kalivoid2047/TIFF_TESTER_PRO_SD/ESP32_Firmware_V2/README.md

# ESP32_Firmware_V2 — Bluetooth Classic "V2" firmware

`TIFF_TESTER_PRO_V2_ESP32.ino` (V2.2.1) is the **separate Bluetooth-Classic-only
firmware line** for the ESP32-WROOM-DA. It was added to the repo as the
original V2.2 file and then changed in one place: V2.2.1 reads relay/MOSFET
state back from the Nano (see "Changes from V2.2" below). It is *not* the main firmware in
[`../ESP32_Firmware`](../ESP32_Firmware) and the two do not share code or
wire protocol.

| | Main firmware (`ESP32_Firmware/`) | V2 (`ESP32_Firmware_V2/`) |
|---|---|---|
| Link | BLE GATT (PIN) + Wi-Fi AP | Bluetooth Classic SPP (`TIFF_TESTER_V2`), no PIN |
| Nano | UART, text protocol, independent safety MCU | **I2C slave at 0x12**, binary commands |
| Relays | DUT relay + aux relays 2–4 on the Nano, with test + polarity control | DUT relay on ESP32 GPIO27 + Nano relays 1–4 and MOSFETs 1–2 |
| Diagnostics | CAN/ISO-TP/UDS, K-Line/KWP (read-only) | MCP2515 reset check and K-Line UART only |
| Module files | `[SECTION]` INI | flat `KEY=VALUE`, must pass `VALIDATE_MODULE` |

## Build

- Board: ESP32 (core 3.x — it uses `esp_task_wdt_config_t`), with Bluetooth Classic enabled.
- Library: **Adafruit INA219** (installs Adafruit BusIO).
- CI compiles it (`compile-esp32-v2` in `.github/workflows/ci.yml`).

## Wiring assumptions (from the sketch header)

12 V bench; GPIO34 gets a *protected* divider signal (never raw 12 V); INA219
at 0x40; Nano at I2C 0x12; Nano relay inputs active-LOW, MOSFETs active-HIGH;
MCP2515 defaults to an 8 MHz crystal (edit the sketch for 16 MHz). Pins:
I2C 21/22, SPI 18/19/23, MCP2515 CS 5, SD CS 13, K-Line RX/TX 16/17, supply ADC
34, position ADC 36, temperature ADC 39, DUT relay 27.

## Text protocol (newline-terminated; replies use `|` separators)

`STATUS`/`READ_LIVE_DATA`, `LIST_MODULES`, `READ_MODULE|f`, `ADD_MODULE|f|K=V|…`,
`DELETE_MODULE|f`, `SELECT_MODULE|f`, `VALIDATE_MODULE|f`, `VALIDATE_ALL_MODULES`,
`PRETEST`, `START_TEST`, `END_TEST`, `POWER_ON`, `POWER_OFF`, `ALL_OFF`,
`RESET_FAULT`, `RELAY1_ON`…`RELAY4_OFF`, `MOSFET1_ON`…`MOSFET2_OFF`, `SERIAL_LIVE`.

`STATUS` returns one line:
`VOLTAGE=…,DUT_VOLTAGE=…,CURRENT=…,POWER=…,POSITION=…,TEMP=…,DUT=ON|OFF,FAULT=…,NANO=…,R1=…,R2=…,R3=…,R4=…,M1=…,M2=…,INA219=…,SD=…,CAN=…,KLINE=…,WATCHDOG=OK,MODULE=…,STATUS=TESTING|IDLE`
(`R1..R4`/`M1..M2` are `ON`, `OFF`, or `UNKNOWN` if the Nano isn't answering).

## Changes from V2.2

V2.2.1 uses the status byte the Nano already returns (it used to be thrown
away apart from "answered / didn't"):

- `STATUS` gains `R1..R4`, `M1`, `M2` read back from the Nano.
- Each `RELAYn_*` / `MOSFETn_*` command is **verified**: after sending it the
  ESP32 reads the Nano's status and replies `OK|RELAY2=ON|CONFIRMED`, or
  `ERROR|RELAY2=ON_NOT_CONFIRMED|NANO_FAULT=YES` (or `=NO`) if the Nano refused it.
  The Nano ignores "on" commands while its heartbeat is stale or its e-stop is
  pressed, which previously looked like success.
- If the Nano's fault bit (e-stop / heartbeat lost) is set, `PRETEST` fails with
  `NANO_FAULT`, and a running test is stopped with fault `NANO_FAULT`.
- `FW_VERSION` is `2.2.1`. The boot banner text still says V2.2.

Needs the matching Nano sketch (`../Arduino_Nano_V2`); a Nano that doesn't
implement the status byte shows `UNKNOWN`/`NOT_CONFIRMED` for outputs.

## Nano I2C protocol and the matching Nano sketch

The Nano side is [`../Arduino_Nano_V2`](../Arduino_Nano_V2/TIFF_TESTER_PRO_V2_NANO.ino),
written against this sketch's protocol. The ESP32 writes one command byte to
address 0x12: `0x01` get status (then reads 1 byte back; `0xFF` = no answer),
`0x02` all off, `0x03` heartbeat, `0x10/0x11` R1 on/off … `0x16/0x17` R4,
`0x20/0x21` M1, `0x22/0x23` M2. The ESP32 faults with `NANO_OFFLINE` if the Nano
stops answering.

Nano pins: relays 1-4 on D4/D5/D7/D8 (active-LOW), MOSFETs 1-2 on D9/D10
(active-HIGH), e-stop on D3 (normally-closed contact to GND with the pull-up;
pressed or broken wire = e-stop; jumper D3 to GND if none is fitted), status LED D13,
I2C on A4 (SDA) / A5 (SCL). The status byte returned is: bits 0-3 relays, bits
4-5 MOSFETs, bit 6 fault (heartbeat lost or e-stop), bit 7 always 0 (so it can
never equal 0xFF). **V2.2.1 of the ESP32 sketch decodes this byte** and reports relay/MOSFET
state and the fault bit (original V2.2 only checked "answered / didn't").

**I2C levels:** ESP32 is 3.3 V, Nano is 5 V. The Nano sketch disables its
internal pull-ups, but you still need a bidirectional level shifter (BSS138
type) or pull-ups to 3.3 V, plus common ground.

## Things to know about this firmware (observations, nothing changed)

- **`TEMP` is not degrees C.** `readTemperatureC()` is a placeholder that
  returns the raw ADC voltage (see the comment in the sketch). The app shows
  temperature as n/a for V2 for that reason.
- **Relay state is the Nano's own report of what it commanded**, not a measurement
  of the relay contacts or load: nothing on this hardware observes the output
  side of the relays.
- **The DUT relay is active-HIGH** on GPIO27 (`HIGH` = on), while the header's
  "relay inputs are active LOW" refers to the Nano's relay outputs. The
  separate V2.3 notes asked for an active-low DUT relay; this V2.2 file is not
  that version.
- **Safety checks only run during a test.** Over-current, supply-range and
  Nano-online checks (`safetyCheck()`) return immediately unless `START_TEST`
  is active, so a bare `POWER_ON` or a manual relay command is not
  supervised by them.
- Module-file keys differ from the main firmware's schema (`COMM`, `CAN_SPEED`,
  `CAN_TX`/`CAN_RX` as decimal, `VOLTAGE_MIN`, …); the INI parser is a flat
  substring search, so commented lines are not ignored.
- Not validated against real hardware.
