kalivoid2047/TIFF_TESTER_PRO_SD/Documentation/app_screenshots/02_home.png

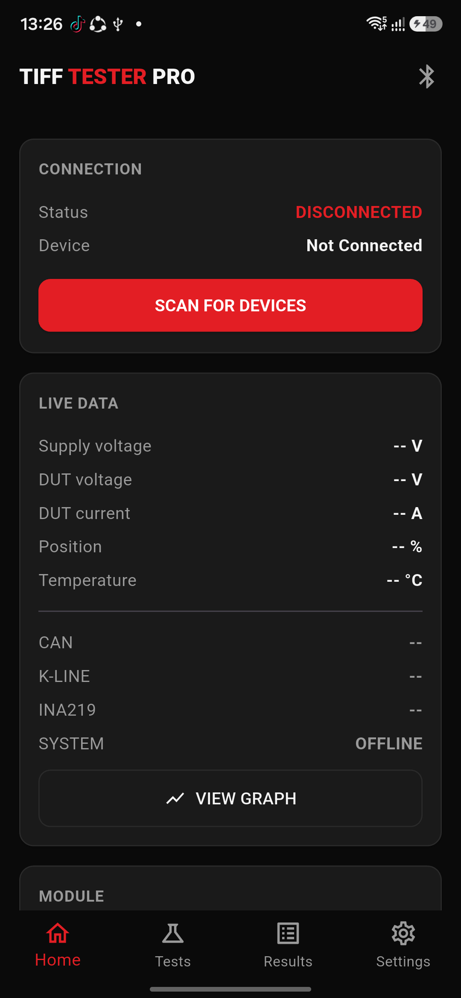
Documentation/app_screenshots/02_home.png
