kalivoid2047/TIFF_TESTER_PRO_SD/Documentation/app_screenshots/03_home_scrolled.png

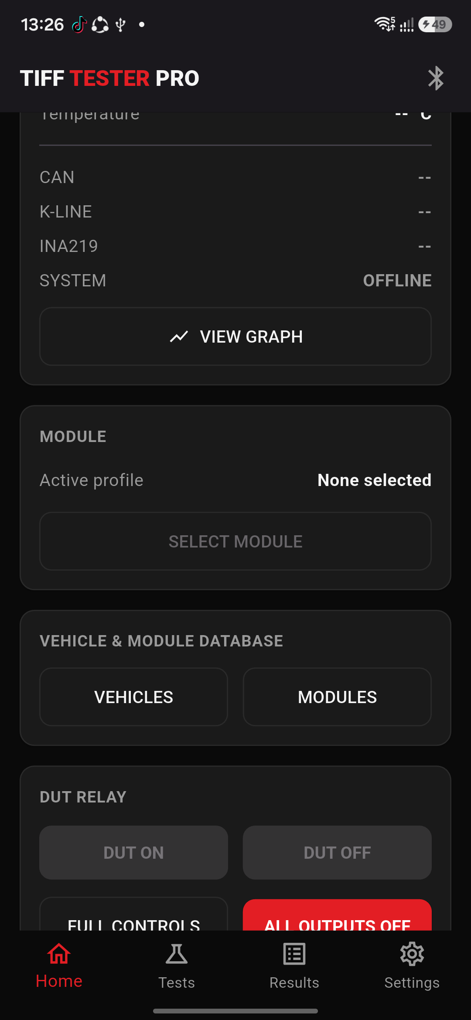
Documentation/app_screenshots/03_home_scrolled.png
