kalivoid2047/TIFF_TESTER_PRO_SD/Documentation/app_screenshots/06_settings_tab.png

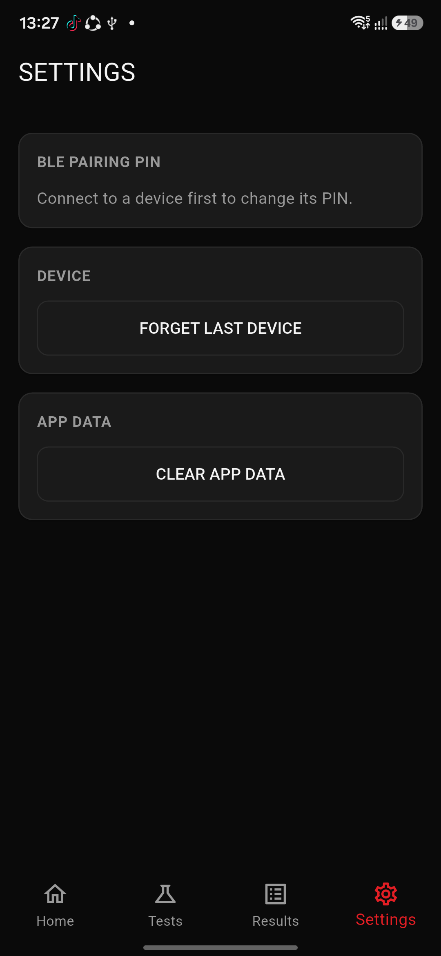
Documentation/app_screenshots/06_settings_tab.png
