kalivoid2047/TIFF_TESTER_PRO_SD/Documentation/app_screenshots/08_scan_devices.png

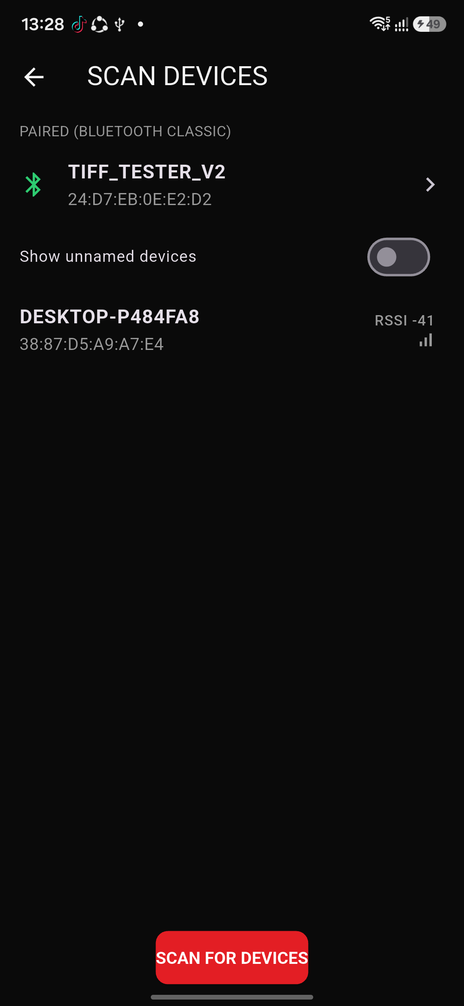
Documentation/app_screenshots/08_scan_devices.png
