kalivoid2047/TIFF_TESTER_PRO_SD/Documentation/app_screenshots/11_live_graph.png

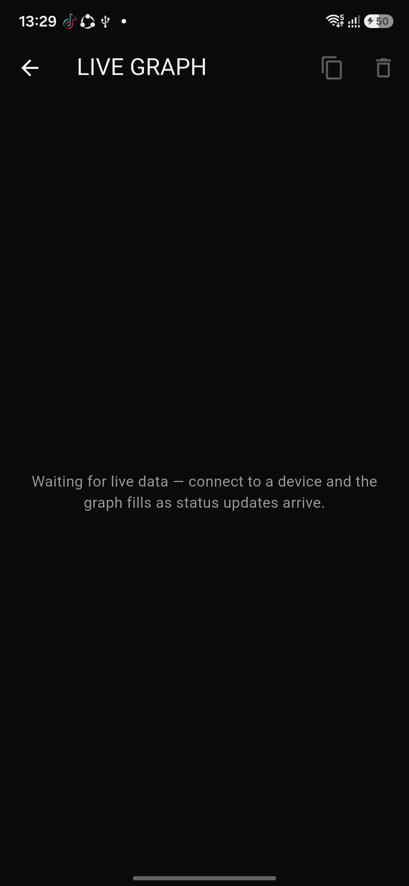
Documentation/app_screenshots/11_live_graph.png
