kalivoid2047/TIFF_TESTER_PRO_SD/Documentation/app_screenshots/12_full_controls.png

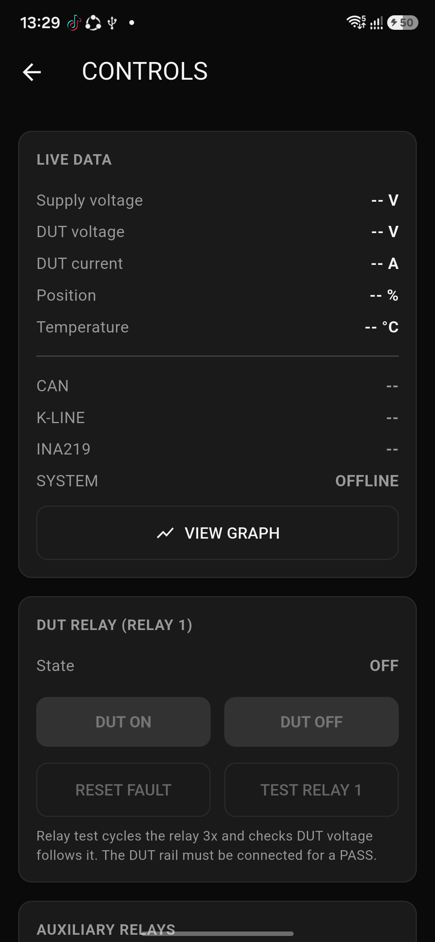
Documentation/app_screenshots/12_full_controls.png
