kalivoid2047/TIFF_TESTER_PRO_SD/Documentation/app_screenshots/13_home_snackbar_connect_first.png

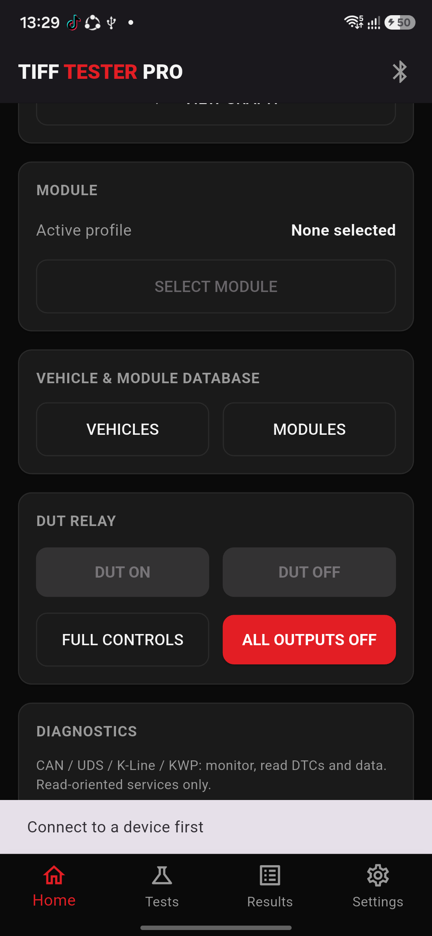
Documentation/app_screenshots/13_home_snackbar_connect_first.png
