kalivoid2047/TIFF_TESTER_PRO_SD/Documentation/app_screenshots/15_vehicles_list.png

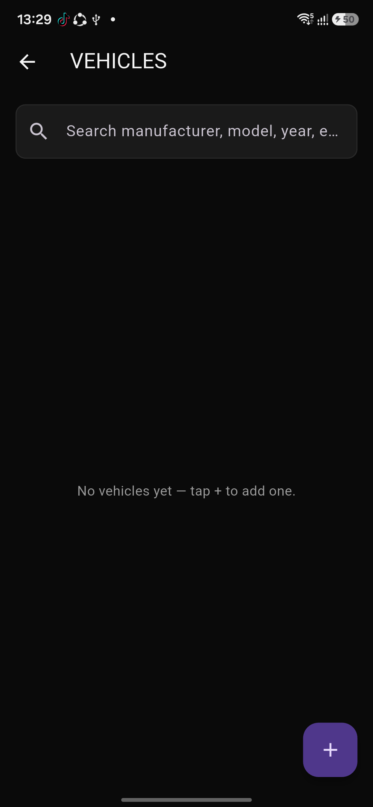
Documentation/app_screenshots/15_vehicles_list.png
