kalivoid2047/TIFF_TESTER_PRO_SD/Documentation/app_screenshots/17_diagnostics_can.png

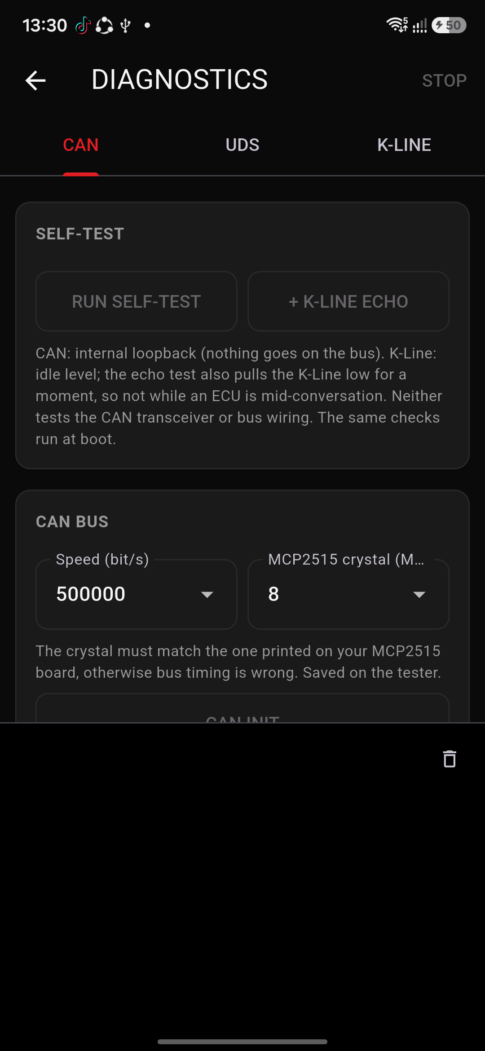
Documentation/app_screenshots/17_diagnostics_can.png
