kalivoid2047/TIFF_TESTER_PRO_SD/Documentation/app_screenshots/18_diagnostics_uds.png

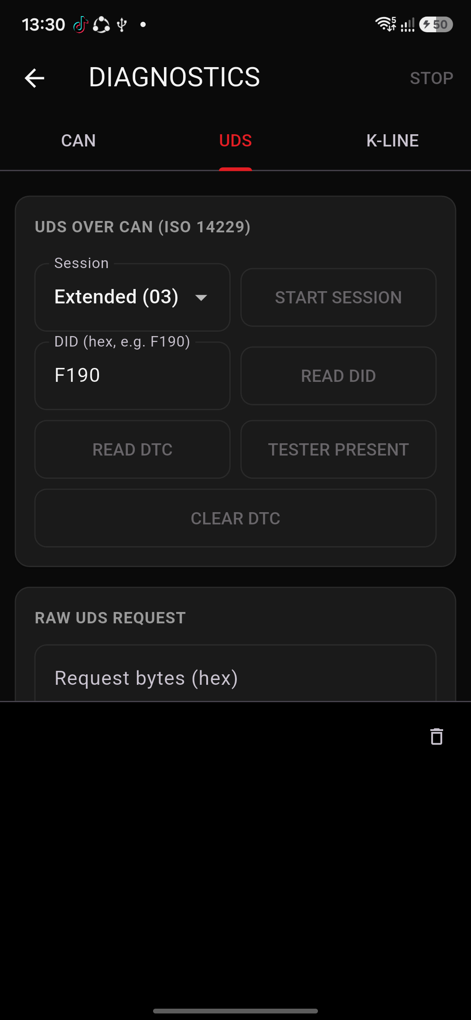
Documentation/app_screenshots/18_diagnostics_uds.png
