kalivoid2047/TIFF_TESTER_PRO_SD/Documentation/app_screenshots/19_diagnostics_kline.png

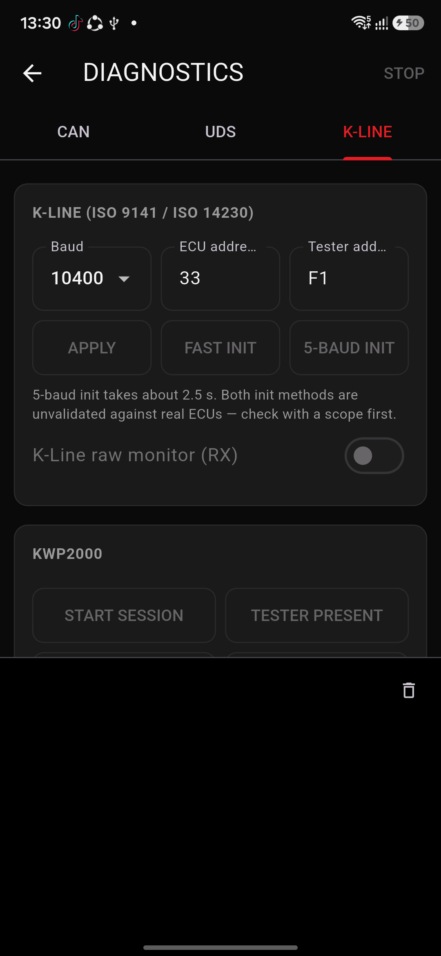
Documentation/app_screenshots/19_diagnostics_kline.png
