kalivoid2047/TIFF_TESTER_PRO_SD/Documentation/app_screenshots/20_vehicle_form.png

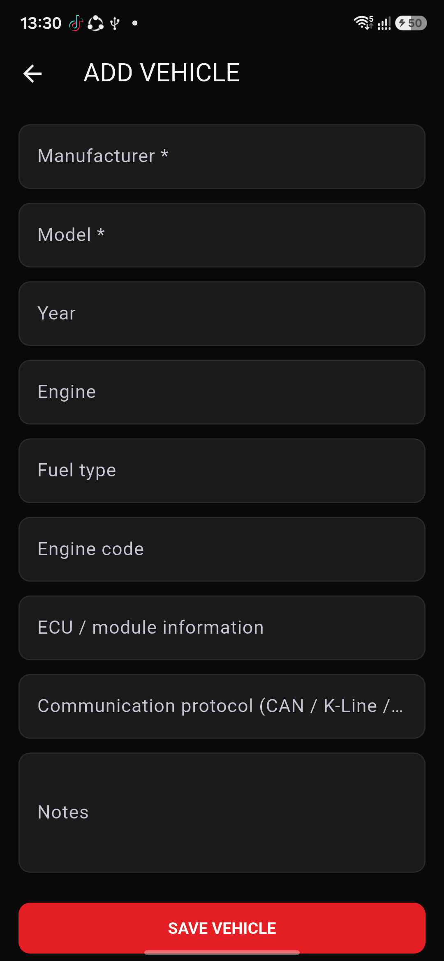
Documentation/app_screenshots/20_vehicle_form.png
