kalivoid2047/TIFF_TESTER_PRO_SD/Documentation/app_screenshots/23_module_form.png

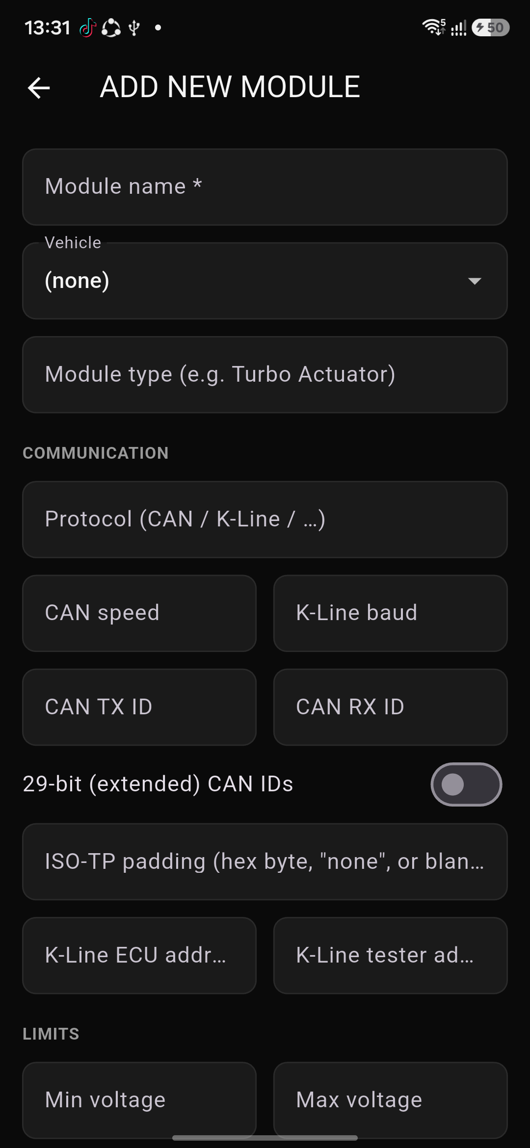
Documentation/app_screenshots/23_module_form.png
