kalivoid2047/TIFF_TESTER_PRO_SD/Documentation/app_screenshots/04_tests_tab.png

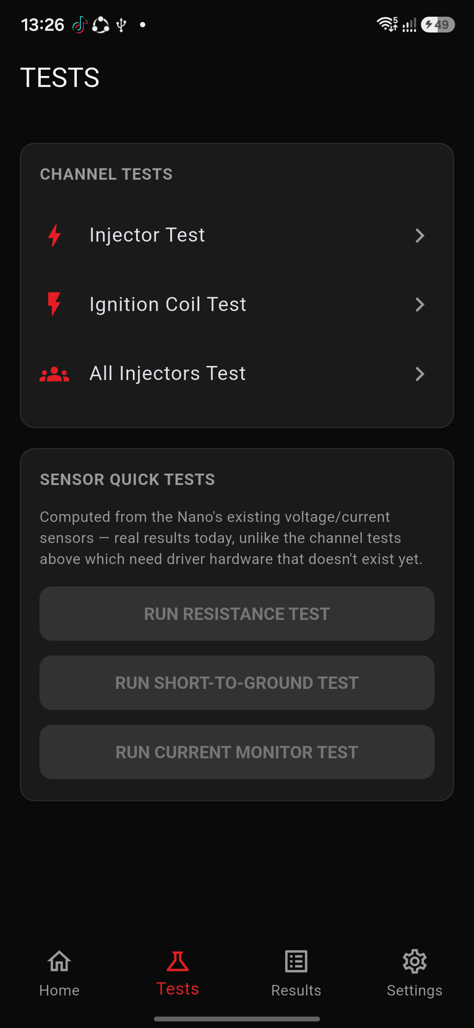
Documentation/app_screenshots/04_tests_tab.png
