kalivoid2047/TIFF_TESTER_PRO_SD/Documentation/app_screenshots/05_results_tab.png

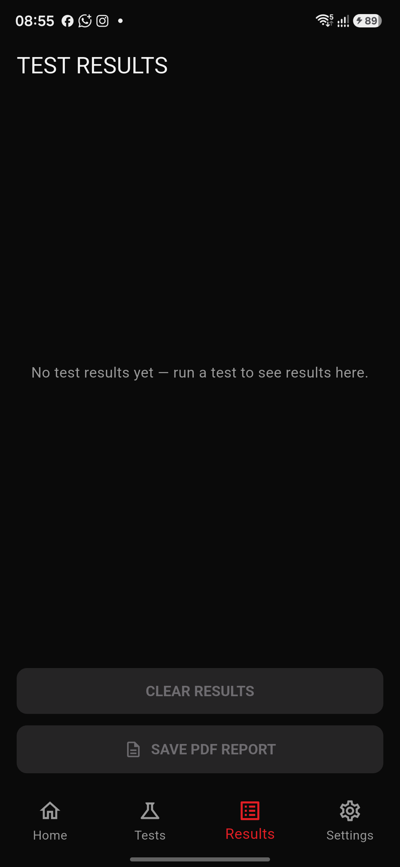
Documentation/app_screenshots/05_results_tab.png
