kalivoid2047/TIFF_TESTER_PRO_SD/Documentation/app_screenshots/07_injector_test.png

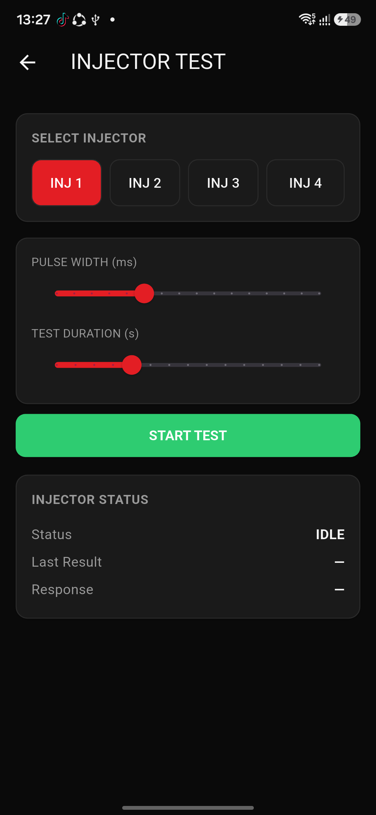
Documentation/app_screenshots/07_injector_test.png
