kalivoid2047/TIFF_TESTER_PRO_SD/Documentation/app_screenshots/09_coil_test.png

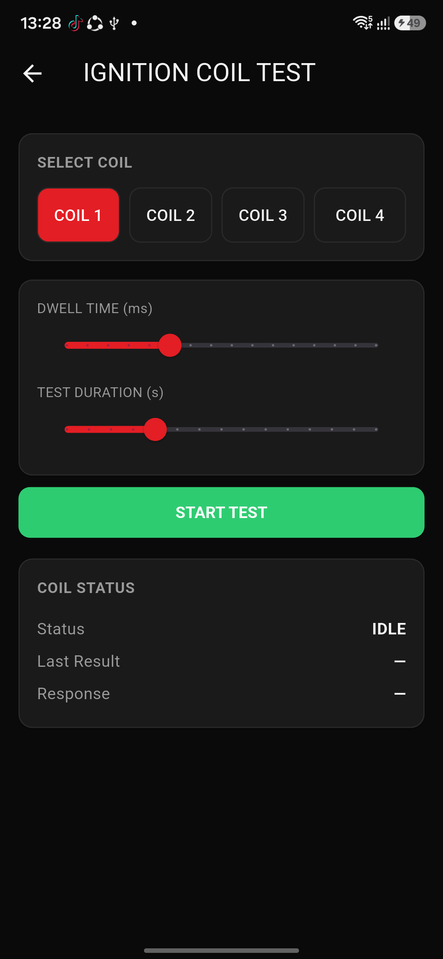
Documentation/app_screenshots/09_coil_test.png
