kalivoid2047/TIFF_TESTER_PRO_SD/Documentation/app_screenshots/10_all_injectors_test.png

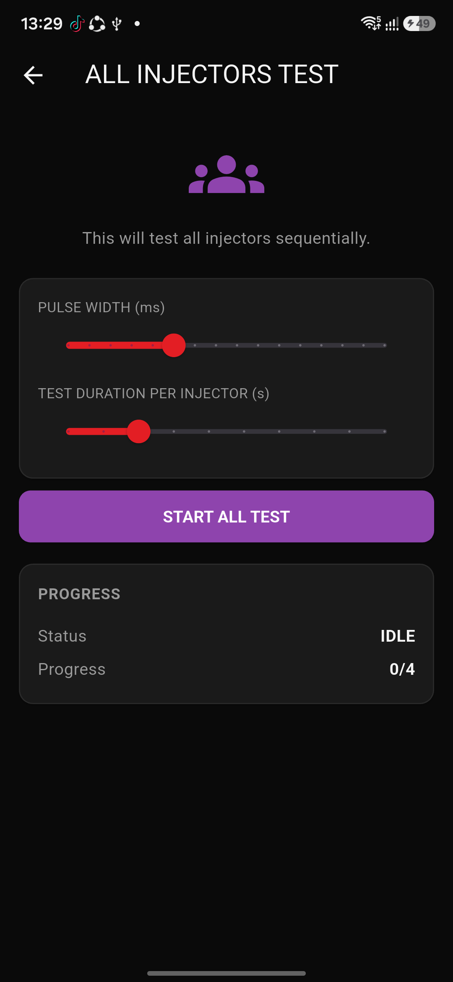
Documentation/app_screenshots/10_all_injectors_test.png
