kalivoid2047/TIFF_TESTER_PRO_SD/(commit log)

2026-08-18 Initial commit: existing firmware, wiring docs, and full documentation set (PRD, SRS, Architecture, UI/UX spec, API spec, Roadmap)
2026-08-18 Add GitHub Actions CI workflow (compile ESP32 + Nano sketches) and badge
2026-08-18 Fix CI: stage sketches into correctly-named folders before compiling
    Arduino tooling requires a sketch's folder name to match its .ino
    filename. This repo groups firmware by controller role instead, so
    copy each sketch into a temp folder with the matching name before
    invoking arduino/compile-sketches, rather than restructuring the repo.
2026-08-18 Implement CAN, K-Line, gated test/service execution, reports, BLE, and configurable calibration/polarity/secrets
    Addresses the 'What's not implemented' list in Documentation/PROJECT_STATUS.md:
    - can_mcp2515.ino: self-contained MCP2515 driver (init/send/receive),
    no external library dependency. Not yet validated against real hardware.
    - kline_iso14230.ino: ISO 14230 fast-init + request/response framing.
    Not yet validated against a real K-Line ECU.
    - test_orchestrator.ino: consumes module profile [TESTS]/[SERVICE]
    sections. Runs resistance/short-to-ground/current-monitor tests using
    existing Nano sensor data. position_sweep/actuator_movement correctly
    report NOT_IMPLEMENTED (need in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
    [TIFF_TESTER_PRO_SD_ESP32.ino, TIFF_TESTER_PRO_SD_NANO.ino, ble_service.ino, can_mcp2515.ino, config.ino, kline_iso14230.ino, shared_types.h, test_orchestrator.ino]
2026-08-18 Fix ESP32 build: switch to huge_app partition scheme
    Wi-Fi + WebServer + SD + BLE + CAN + K-Line together exceed the default
    partition scheme's app space ('text section exceeds available space in
    board'). This confirms the resource-pressure risk flagged in
    Documentation/ARCHITECTURE.md #6. Fixed by using the huge_app partition
    scheme (trades unused OTA space for a bigger app partition) in CI, and
    documented the equivalent Arduino IDE board setting for anyone flashing
    outside CI.
    [TIFF_TESTER_PRO_SD_ESP32.ino]
2026-08-18 Build the TIFF TESTER PRO mobile app in Flutter
    Implements all ten reference screens from Documentation/UI_UX_SPEC.md:
    splash, home/dashboard, scan, PIN connect, injector test, coil test,
    all-injectors test, results (with PDF export), plus first-pass System
    Info and Settings screens and a resolution for the undesigned Tests-tab
    gap (a fuller test menu combining channel tests with the sensor-based
    quick tests).
    - lib/ble/: flutter_blue_plus wrapper speaking the exact GATT contract
    ESP32_Firmware/ble_service.ino implements.
    - lib/state/: AppState (Provider/ChangeNotifier) holding connection
    status, live Nano status, and session results.
    - lib/screens/: one file per screen, dark theme matc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
2026-09-16 Update ROADMAP.md to match current PROJECT_STATUS.md
    Mark Phase 0 open items resolved (git init, BLE auth, SDK, PDF lib),
    reflect that Phase 2's BLE/orchestration/reporting plumbing and the
    CAN/K-Line drivers already landed (unvalidated), and move the CAN/K-Line
    hardware validation task from "not started" to Phase 5 bench-validation.
2026-09-16 Implement four code-only ROADMAP.md items ahead of Phase 1 hardware
    - Mobile app: persist test results across restarts (TestResult
    toJson/fromJson, AppState stores/restores the full list via
    shared_preferences instead of a count-only stub).
    - Mobile app: add a module-selection screen, wired to a new
    readModuleList() BLE call; firmware's modules characteristic is now
    actually populated (shared with the existing /api/modules web handler).
    - Nano: add INJ_TEST/COIL_TEST/TEST_STOP command handling with hard
    pulse-width/dwell caps, continuous safetyOK() supervision for the whole
    test window (not just before it starts), and TEST_STATUS reporting -
    safety-supervision only, since no in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
2026-09-18 Add default-PIN warning to mobile app, close remaining Phase 0/2 roadmap items, fix analyzer lints
    - AppState tracks usingDefaultPin (set on authenticate/setPin), Home
    screen shows a tappable warning banner into Settings when active -
    mirrors the firmware's existing ble_pin_is_default flag, which the
    BLE-only app path had no equivalent for (Phase 4 security-pass item).
    - Fix the 3 issues flutter analyze reported: doc-comment angle brackets
    read as HTML in tiff_ble_service.dart, and an unnecessary double
    underscore in module_selection_screen.dart. flutter analyze and
    flutter test both pass clean now.
    - ROADMAP.md: remove a stray duplicate checklist line, mark the
    Wi-Fi-always-on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
2026-09-29 Fix BLE scan on Android 12+ and add boot diagnostics
    - scan_screen: only require BLUETOOTH_SCAN/CONNECT; location is declared
    only for Android <=11 so requiring it made scanning always fail.
    - scan_screen: use advertisementData.advName (platformName is empty during
    scans), match the TIFF service UUID, and sort TIFF devices first.
    - firmware: print a BOOT: line after each setup() init step to locate
    hangs/crash loops before BLE starts.
    [TIFF_TESTER_PRO_SD_ESP32.ino]
2026-09-29 Add Bluetooth Classic (V2 firmware) support and scan filtering
    - Add TiffClassicLink: SPP/RFCOMM link speaking the V2 firmware's text
    protocol (STATUS polling, POWER_ON/OFF, ALL_OFF, module list/select)
    - Route TiffBleService commands, status and module list through the
    classic link when connected to a paired TIFF_TESTER_V2 board
    - Scan screen: list paired classic TIFF boards, hide unnamed BLE
    devices by default with a "Show unnamed devices" toggle
    - AppState: connectClassic() and connectedName/connectedId so screens
    work for both BLE and classic connections
    - Fail gracefully for tests/PIN changes the V2 firmware doesn't support
    - Android: override compileSdk for flutter_bluetooth_cl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
2026-10-01 Add 4-relay control/testing and live data preview
    Nano: aux relays 2-4 (D5/D7/D8) with fail-safe gating, RELAY/RELAY_TEST
    commands, EXT status line with temperature. ESP32: relay BLE/web API,
    optional INA219 driver, live_data tab (text + JSON), CAN/K-Line/INA219/
    system readiness. App: live data card, relay switches and test buttons.
    [TIFF_TESTER_PRO_SD_ESP32.ino, TIFF_TESTER_PRO_SD_NANO.ino, ble_service.ino, ina219.ino, kline_iso14230.ino, live_data.ino, shared_types.h]
2026-10-01 Add CAN clock selection, relay polarity default, and diagnostics engine
    CAN: 8/16 MHz timing, extended IDs, RX rollover, error reporting. Nano:
    relay polarity defaults to active-low, reported in EXT. ESP32: ISO-TP,
    read-only UDS, K-Line fast/5-baud init and KWP, diagnostics queue with
    DIAG.CSV and per-test CSV logging, module [COMMUNICATION] addressing.
    App: Diagnostics screen, polarity control, module DB addressing fields.
    [HILUX_1KD_TURBO.INI, TIFF_TESTER_PRO_SD_ESP32.ino, TIFF_TESTER_PRO_SD_NANO.ino, ble_service.ino, can_mcp2515.ino, config.ino, diag_engine.ino, kline_iso14230.ino]
2026-10-01 Fix ESP32 compile; configurable ISO-TP padding, unverified-address warnings, V2 handling
    Fix: declare klineError/isotpPadByte/isotpPadding extern in diag_engine.ino
    (Arduino tab order broke the previous push's ESP32 build).
    Padding: per-module can_pad_byte/can_padding, CAN_CONFIG 4th arg, app UI.
    Addressing: no unverified IDs in the example profile; warn when defaults
    are used. INI parser now ignores comment lines and matches at line start.
    V2: app disables diagnostics/aux relays/polarity and shows n/a for fields
    the V2 firmware does not report.
    [HILUX_1KD_TURBO.INI, diag_engine.ino, shared_types.h, test_orchestrator.ino, uds_isotp.ino]
2026-10-01 Add V2 Bluetooth Classic firmware source; map V2 relays and telemetry in app
    ESP32_Firmware_V2/ holds TIFF_TESTER_PRO_V2_ESP32.ino (V2.2) unmodified,
    with a README documenting its protocol and caveats, plus a CI compile job.
    App: RELAY:n,v maps to V2 RELAYn_ON/OFF (shown as last-commanded, V2 has no
    readback); V2 position/INA219/CAN/K-Line parsed; temperature shown n/a
    because V2 reports a raw ADC voltage.
2026-10-01 Add V2 Nano I2C output controller sketch and CI job
    Arduino_Nano_V2/TIFF_TESTER_PRO_V2_NANO.ino implements the I2C protocol the
    V2 ESP32 sketch speaks (address 0x12): relays 1-4, MOSFETs 1-2, heartbeat
    watchdog, optional e-stop, status byte that is never 0xFF. Outputs are off
    at boot and on heartbeat loss; internal I2C pull-ups are disabled for the
    3.3 V ESP32.
2026-10-01 V2.2.1: read relay/MOSFET state back from the Nano
    ESP32 V2 sketch decodes the Nano status byte: STATUS gains R1-R4/M1/M2,
    output commands are verified against the Nano's reply (the Nano ignores
    unsafe ON commands), and a Nano fault bit fails PRETEST / stops a test.
    App shows reported relay state on V2.2.1 and falls back to last-commanded
    on older V2.2. Docs updated.
    [TIFF_TESTER_PRO_V2_ESP32.ino]
2026-10-01 Add protection limits, hold-to-energise, self-tests, live graph and relay names
    Nano: module-tightenable current/voltage limits, persisted over-temperature
    trip and aux auto-off, RELAY_PULSE momentary relays, optional aux feedback
    inputs for real relay-test PASS/FAIL. ESP32: pushes module limits, CAN
    loopback + K-Line self-tests (boot and on request), extra status fields.
    App: Controls protection card and HOLD buttons, live graph with CSV copy,
    PDF live-data table, relay names in module records, self-test button.
    [TIFF_TESTER_PRO_SD_ESP32.ino, TIFF_TESTER_PRO_SD_NANO.ino, ble_service.ino, can_mcp2515.ino, diag_engine.ino, kline_iso14230.ino, live_data.ino, shared_types.h]
2026-10-02 Add hardware bring-up checklist for the bench
    Documentation/BRINGUP_CHECKLIST.md: ordered bench verification of the main
    system (Nano + ESP32 + app) and the V2 line, with expected outputs derived
    from the code and a known-gaps section (e-stop wire-break not detected,
    BLE disconnect does not cut the DUT, UART level shifting, module file
    location).
2026-10-02 Make the e-stop fail-safe against a broken wire
    Both Nano sketches now expect a normally-closed contact between D3 and GND:
    pressed, broken wire or unplugged connector all read HIGH = e-stop. All
    checks go through estopActive() in the main sketch. ESTOP_FAILSAFE_NC 0
    restores the old normally-open behaviour. A board with no e-stop needs D3
    jumpered to GND. Wiring doc, V2 README, status table and bring-up checklist
    updated, including wire-break and open-at-boot tests.
    [TIFF_TESTER_PRO_SD_NANO.ino, TIFF_TESTER_PRO_V2_NANO.ino]
2026-10-02 Add bench wiring diagrams for the main system and the V2 line
    Documentation/WIRING_DIAGRAM.md with WIRING_MAIN.svg and WIRING_V2.svg,
    connection tables from the sketches' pin maps, and must-check lists
    (UART and 5 V-logic module levels, e-stop contact type, V2 DUT relay
    polarity and I2C level shifting). Generator scripts in Documentation/diagrams.
2026-10-02 Add firmware flashing guide
    Documentation/FLASHING_GUIDE.md: toolchain and board settings matching CI
    (Huge APP partition, Old Bootloader Nano), staging commands for the
    correctly named sketch folders, per-chip flash and verify steps for the
    main system and the V2 line, Android app build/install, first-boot
    credentials, what survives a re-flash, and troubleshooting. Linked from the
    README and bring-up checklist.
2026-10-02 Add app user guide
    Documentation/APP_USER_GUIDE.md: screen-by-screen guide written from the
    app code - connecting and the PIN screen (wrong PIN is not detected at
    connect), Home, live data and graph, Controls (relays, hold, protection,
    polarity), module selection, tests, results/PDF, diagnostics, vehicle and
    module records, settings, V2 differences, and troubleshooting. Includes a
    what-works-today table (channel tests are NOT_IMPLEMENTED).
2026-10-05 Fix Android Back button exiting the app from pushed screens
    On Android 16 (target SDK 36) the system ignores the legacy back handler
    unless the app opts in to OnBackInvokedCallback, so Back on a pushed
    screen (e.g. Injector Test) closed the whole app instead of popping.
2026-10-05 Add end-to-end app screenshots from a physical device
    Captured on a Samsung A16 (Android 16) with no ESP32 link, so live
    screens show their disconnected state.
2026-10-05 Wait for the real Bluetooth Classic connection result
    The plugin's connect() returns true as soon as its socket thread starts;
    the actual outcome arrives on onConnectionChanged. The app treated that
    early true as "connected", showing default 0.0 readings and then
    "dropping" when the board never answered (PAGE_TIMEOUT).
    connect() now waits for the connection event (20s timeout) and throws a
    readable error on failure, which the scan screen already displays. Status
    polls no longer raise unhandled errors when the link is down.
2026-10-05 Make Results screen buttons full width
    The Clear Results / Save PDF Report buttons sat in a Column with the
    default centered cross-axis alignment, so they shrank to their label
    width (and the PDF label touched the button edge). Stretch them to match
    the other screens, and refresh the Results screenshot.
2026-10-05 Add MOSFET 1/2 ON/OFF control for the V2 board
    The Controls screen showed MOSFET 1-2 as disabled "pending hardware" rows
    even though the V2 firmware already supports MOSFET1_ON/OFF and
    MOSFET2_ON/OFF and reports M1/M2 in its status line.
    - Parse M1/M2 into NanoStatus (mosfets / mosfetsReported).
    - Translate MOSFET:<n>,<0|1> to the V2 text commands.
    - AppState.setMosfet with a commanded-state fallback for firmware that
    doesn't report MOSFET state; cleared on fault, disconnect and ALL
    OUTPUTS OFF.
    - Replace the placeholder with real ON/OFF switches, enabled only when
    connected to the V2 (Bluetooth Classic) board.
    - Update the user guide.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
2026-10-05 Make Scan screen button full width
    Same cause as the Results screen: a bare button inside a Column with the
    default centered cross-axis alignment shrank to its label width.
2026-10-05 Use the brand car mark as the app icon
    Replace the default Flutter launcher icon with the red car glyph the
    splash screen uses (#E31E24 on #0A0A0A): adaptive icon (foreground +
    background colour + monochrome layer for themed icons) and legacy PNGs
    for pre-Android-8 devices.
